rhinocerose/eurorack-jakplugg-uO_c/uO_C BOM 1.1 17 Apr 18.xlsx

Sheet: BOM
Quantity | Value | Name | RefDes | Mouser | Other | Notes
 |  |  |  | Capacitors
4 | 22p | CAP_0805 | C15, C16, C17, C18 | 77-VJ0805A220GXAPBC (https://www.mouser.com/Search/ProductDetail.aspx) |  | or 18p
4 | 560p | CAP_0805 | C22, C25, C26, C27 | 77-VJ0805A561JXAAC (http://www.mouser.com/ProductDetail/Vishay-Vitramon/VJ0805A561JXAAC/?qs=ReTA%2F0kwlVYgsqJl6lJxLg%3D%3D)
16 | 0.1u | CAP_0805 | C5, C6, C8, C9, C10, C11, C12, C13, C19, C20, C21, C30, C31, C32, C34, C35 | 80-C0805C104K5R (https://www.mouser.com/Search/ProductDetail.aspx)
3 | 0.47u | CAP_0805 | C14, C29, C33 | 581-080516C474K (https://www.mouser.com/ProductDetail/AVX/0805YC474KAT2A/)
2 | 1u | CAP_0805 | C23, C28 | 81-GCM21BR71H105KA3L (https://www.mouser.com/Search/ProductDetail.aspx)
2 | 10u | CAP_1206 | C3, C4 | 81-GRM319R61E106KA2D (https://www.mouser.com/ProductDetail/Murata-Electronics/GRM319R61E106KA12D/)
2 | 22u | CPOL-USC | C1, C2 | 667-EEE-FK1V220R (https://www.mouser.com/Search/ProductDetail.aspx) |  | 35V
2 | 10u | CPOL-USC | C7, C24 | 667-EEE-FK1E100R (https://www.mouser.com/Search/ProductDetail.aspx) |  | 25V
 |  |  |  | Resistors
1 | 4.7 | R-US_R1206 | R60 | 660-RK73B2BTTDD4R7J (http://www.mouser.com/ProductDetail/KOA-Speer/RK73B2BTTDD4R7J/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)
4 | 100 | RES_0805 | R25, R29, R33, R37 | 660-RK73H2ATTD1000F (http://www.mouser.com/ProductDetail/KOA-Speer/RK73H2ATTD1000F/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)
4 | 220 | RES_0805 | R4, R6, R10, R12 | 279-CPF0805B220RE1 (https://www.mouser.com/Search/ProductDetail.aspx) |  | 0.10% | 0.1% Not REALY needed, It will just result in less trimming adjustment
2 | 510 | RES_0805 | R40, R41 | 603-RC0805JR-07510RL (https://www.mouser.com/Search/ProductDetail.aspx)
1 | 2k | RES_0805 | R39 | 660-RK73H2ATTE2001F (https://www.mouser.com/Search/ProductDetail.aspx)
1 | 10k | RES_0805 | R42 | 660-RK73H2ATTD1002F (https://www.mouser.com/Search/ProductDetail.aspx)
4 | 24k9 | RES_0805 | R1, R2, R7, R8 | 756-PCF0805R-24K9BT1 (https://www.mouser.com/Search/ProductDetail.aspx) |  | 0.10% | 0.1% Not REALY needed, It will just result in less trimming adjustment
8 | 33k | RES_0805 | R16, R18, R20, R22, R24, R28, R32, R36 | 660-RK73H2ATTD3302F (https://www.mouser.com/Search/ProductDetail.aspx)
2 | 47k | RES_0805 | R13, R14 | 660-RK73H2ATTD4702F (https://www.mouser.com/Search/ProductDetail.aspx)
4 | 75k | RES_0805 | R26, R30, R34, R38 | 660-RK73H2ATTD7502F (https://www.mouser.com/Search/ProductDetail.aspx)
13 | 100k | RES_0805 | R3, R5, R9, R11, R15, R17, R19, R21, R23, R27, R31, R35, R53 | 279-CPF0805B100KE (https://www.mouser.com/Search/ProductDetail.aspx) |  | 0.10% | 0.1% Not REALY needed, It will just result in less trimming adjustment
 |  |  |  | Inductor
1 | 10uH |  | L1 | 963-LB3218T100K (https://www.mouser.com/Search/ProductDetail.aspx)
 |  |  |  | Semiconductors
1 |  | DAC8565 | U2 | 595-DAC8565ICPW (https://www.mouser.com/Search/ProductDetail.aspx)
1 |  | LM4040_EM3-5.0 | U6 | 926-LM4040DIM350NOPB (https://www.mouser.com/Search/ProductDetail.aspx)
1 | ADP150 3.3V | ADP150 3.3V | U7 | 584-ADP150AUJZ-3.3R7 (https://www.mouser.com/Search/ProductDetail.aspx)
1 |  | Teensy 3.2 | U1 | 485-2756 (https://www.mouser.com/Search/ProductDetail.aspx?R=2756virtualkey54950000virtualkey485-2756) |  | cheapest at osh park
1 | MB1S | MB1S | D7 | 512-MB1S (https://www.mouser.com/Search/ProductDetail.aspx?R=MB1Svirtualkey51210000virtualkey512-MB1S)
2 |  | MCP6002 | U5, U10 | 579-MCP6002T-I/SN (https://www.mouser.com/Search/ProductDetail.aspx)
2 |  | OPA2172 | U3, U4 | 595-OPA2172IDR (https://www.mouser.com/Search/ProductDetail.aspx)
1 |  | MIC803 | U12 | MIC803-26D4VM3-TR (https://www.mouser.com/ProductDetail/Microchip-Technology-Micrel/MIC803-26D4VM3-TR) |  | supervisor option
4 |  | MMBT3904 | Q1, Q2, Q3, Q4 | 512-MMBT3904 (https://www.mouser.com/Search/ProductDetail.aspx?R=MMBT3904virtualkey51210000virtualkey512-MMBT3904)
1 | LM1117-5 | REG1117T | IC6 | 511-LD1117DT50C-TR (https://www.mouser.com/Search/ProductDetail.aspx)
 |  |  |  | Controls
2 |  | PEC11 | E1, E2 | 858-EN11-HSM1BF20 (http://www.mouser.com/ProductDetail/TT-Electronics/EN11-HSM1BF20/)
2 |  | 6mm Tactile SW | U8, U9 | 612-TL1105SPF100Q (https://www.mouser.com/Search/ProductDetail.aspx)
12 |  | Thonkiconn | J1, J2, J3, J4, J5, J6, J7, J8, J9, J10, J11, J12 |  |  | Thonk/Synthcube/Erthenvar
 |  |  |  | Other Hardware
2 |  | Tact Caps |  | 612-1R-RD (https://www.mouser.com/Search/ProductDetail.aspx?R=1RREDvirtualkey61200000virtualkey612-1R-RD) |  | colors, change last letters. BLK, WHT
2 |  |  |  | 481-0007 (http://www.mouser.com/ProductDetail/Eagle-Plastic-Devices/481-0007/?qs=sGAEpiMZZMv9NFGNGF1lwip6rtQWoF3E) |  | Extra M7 Nuts for Mounting
1 | 10 pin power header | M05X2PTH | JP1 | 49-67996-410HLF (https://www.mouser.com/Search/ProductDetail.aspx)
2 |  |  |  | 761-M0505-25-N (http://www.mouser.com/ProductDetail/RAF-Electronic-Hardware/M0505-25-N/) |  | M2.5 Spacer
4 |  |  |  | 534-29301 (http://www.mouser.com/ProductDetail/Keystone-Electronics/29301/) |  | M2.5 Screws, 6mm
6 |  |  |  |  | Amazon | washer, Nylon M2.5. These need to end up to be 3mm thick so double them up, etc.
1 |  |  | RESET POGO PIN | 855-P70-2300045R (https://www.mouser.com/ProductDetail/Harwin/P70-2300045R)
1 | 7 pin 128x64 OLED |  |  | ebay, amazon, alibaba, etc.

Sheet: DISPLAY PCB
Quantity | Value | Name | RefDes | Mouser | Other | Notes
1 |  | 1306_disp_O_C | U11 |  | http://www.buydisplay.com/default/serial-spi-1-3-inch-128x64-oled-display-module-ssd1306-white-on-black
4 | 10K | RESISTOR0603MINI | R2, R4, R5, R6 |  | Resistors
1 | 390K | RESISTOR0603MINI | R3 |  | Resistors
5 | 2.2uF | CAP_CERAMIC0603MINI | C3, C4, C6, C7, C8 |  | Ceramic Capacitors
1 | 10uF | CAP_CERAMIC0603MINI | C5 |  | Ceramic Capacitors
1 |  | HEADER-1X7ROUND | JP1 |  | PIN HEADER
1 |  | DISPLAY PCB |  |  | https://oshpark.com/shared_projects/3olQy5tV
