rhinocerose/eurorack-jakplugg-uO_c/(list of files, drawings)

Other design files:
pcb-files/diptrace/uO_c1.1.dip
pcb-files/diptrace/uO_c.dch
