rhinocerose/eurorack-jakplugg-uO_c/pcb-files/eagle/uO_c.brd

## EAGLE design pcb-files/eagle/uO_c.brd (2025-08-10)

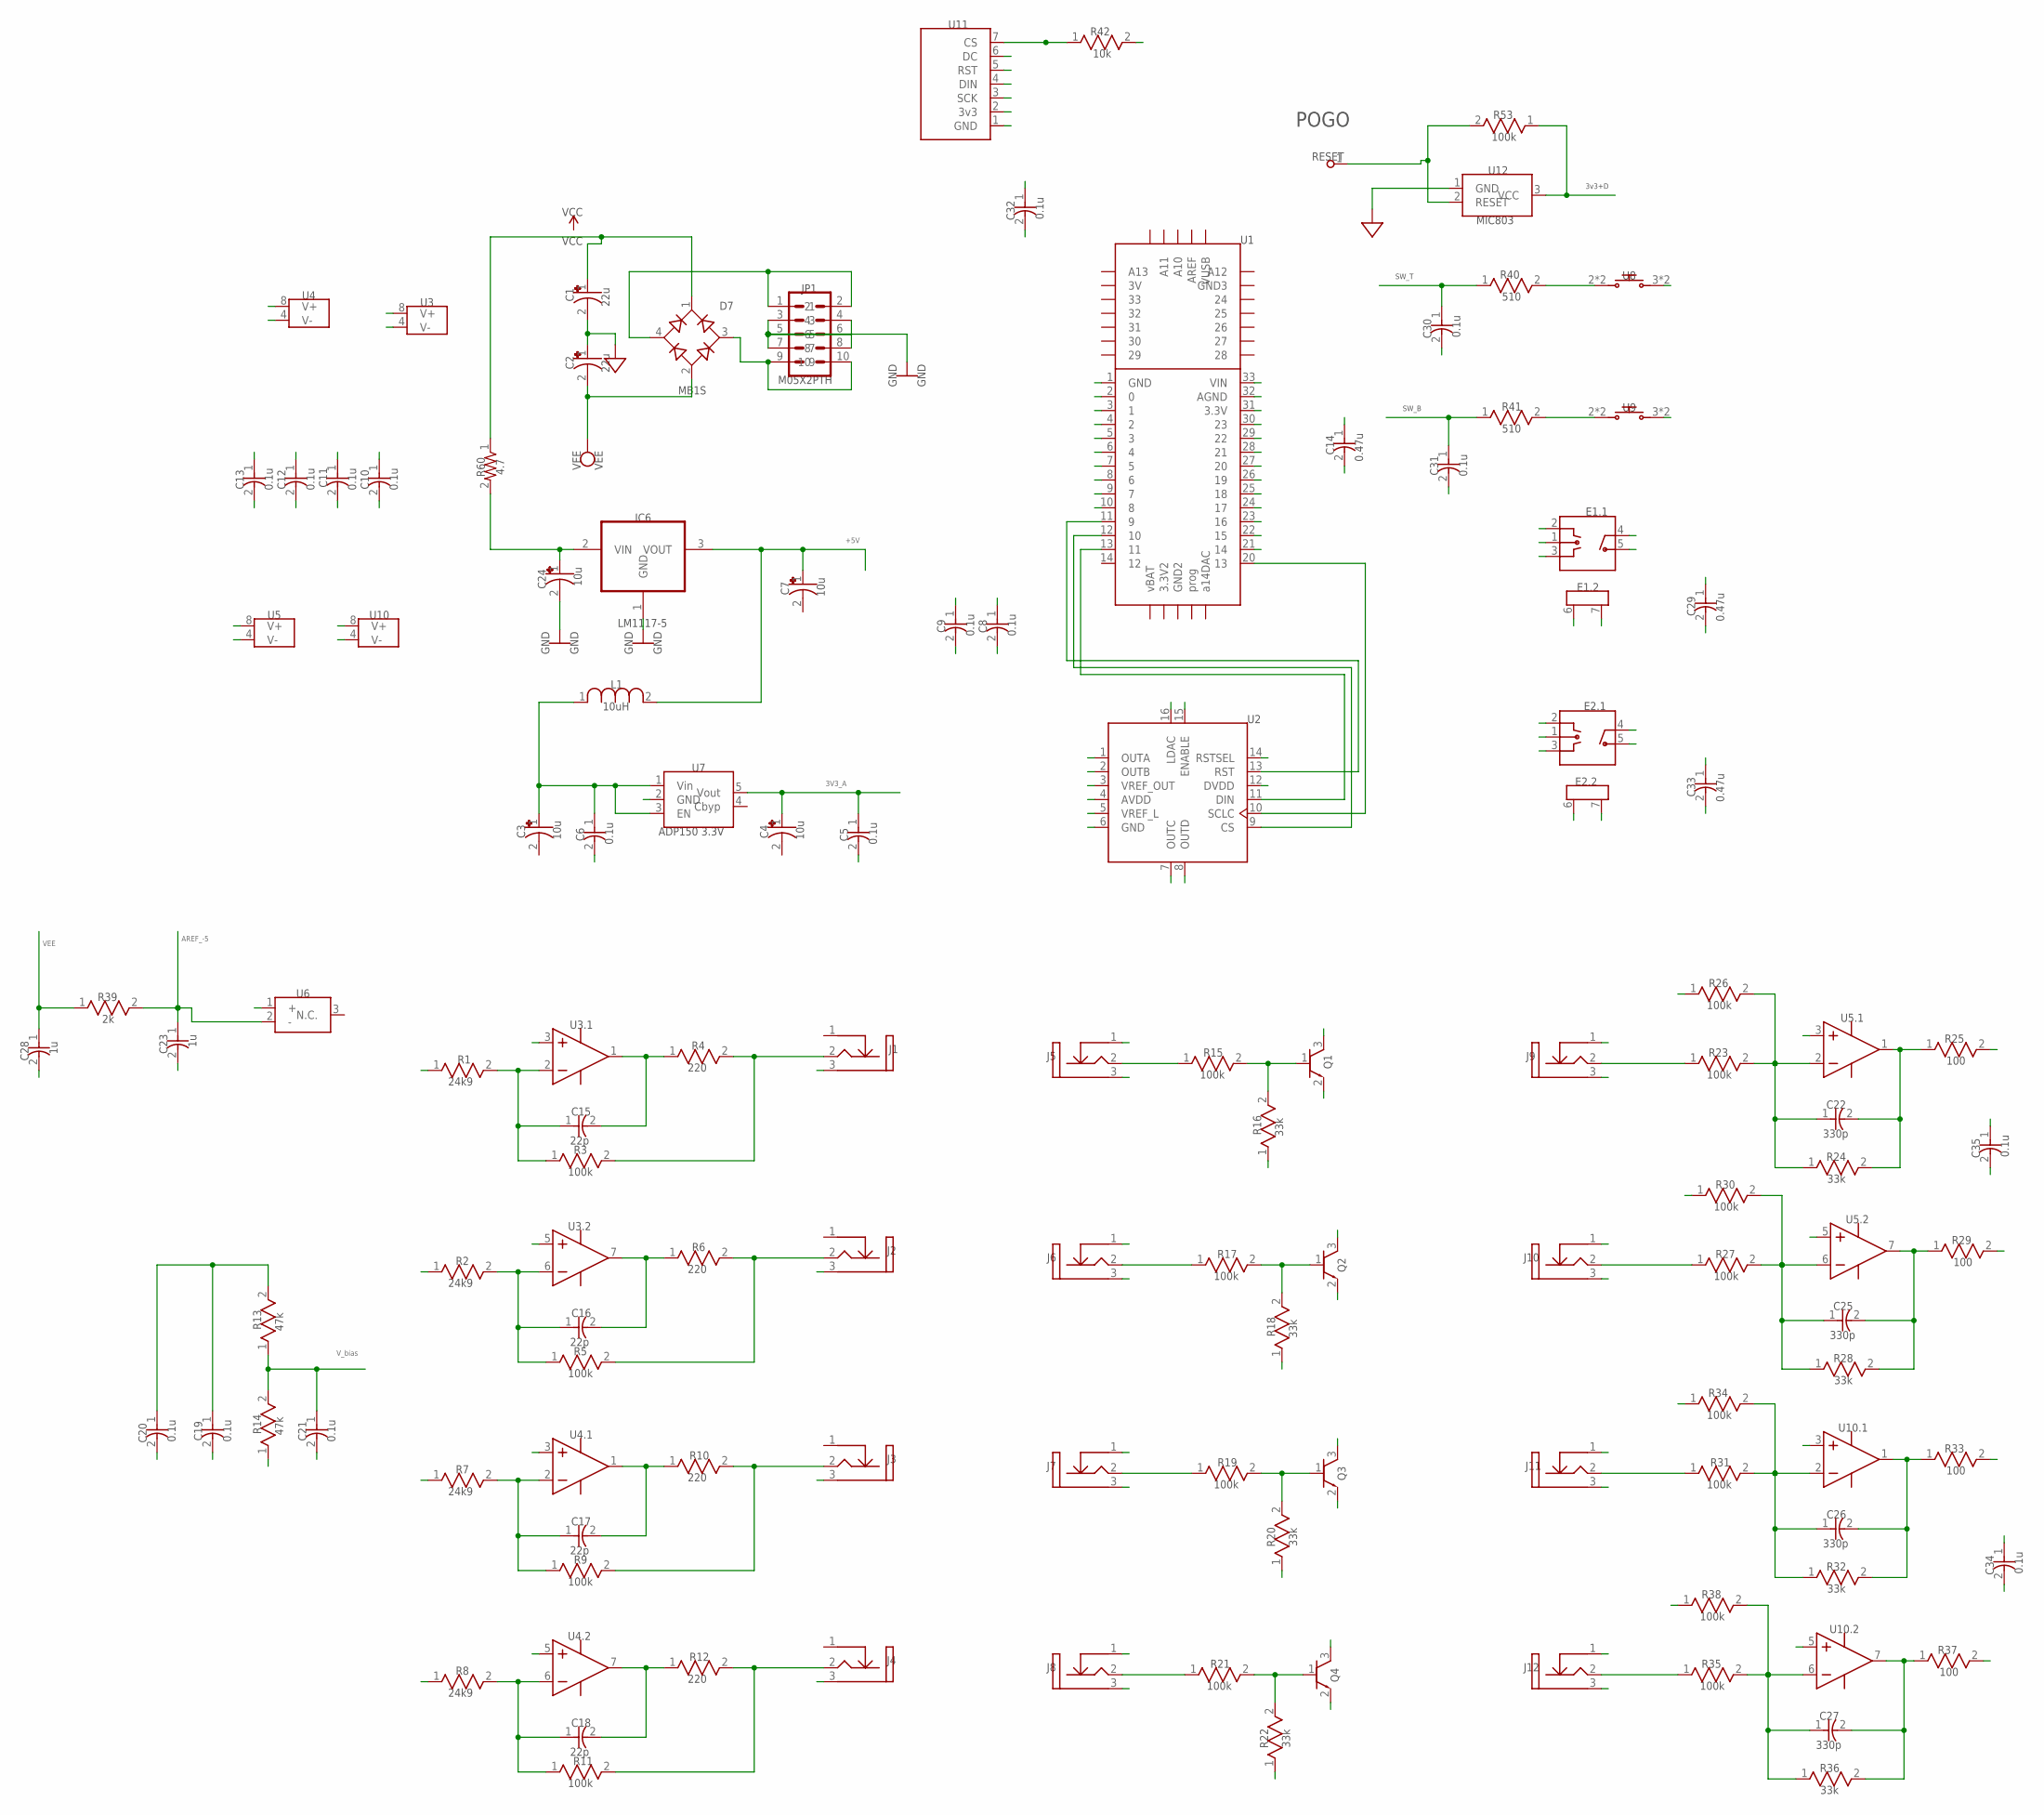
[picture p7: schematic uO_c.sch, Sheet1]

Parts:
C1, C2: 22u; CAPAE-5.3X5.3H3
C3, C4, C7, C24: 10u; CAPAE-5.3X5.3H3
C5, C6, C8, C9, C10, C11, C12, C13, C19, C20, C21, C30, C31, C32, C34, C35: 0.1u; CAP_0805
C14, C29, C33: 0.47u; CAP_0805
C15, C16, C17, C18: 22p; CAP_0805
C22, C25, C26, C27: 330p; CAP_0805
C23, C28: 1u; CAP_0805
D7: MB1S; SOP-4/6.5X2.54
E1, E2: PEC11
IC6: LM1117-5; TO252
J1, J2, J3, J4: THONKICONN; THONKICONN_JACK
J5, J6, J7, J8, J9, J10, J11, J12: THONKICONN_20; THONKICONN_JACK
JP1: M05X2PTH; AVR_ICSP
L1: 10uH; RES_1210
Q1, Q2, Q3, Q4: MMBT3904; SOT23
R1, R2, R7, R8: 24k9; RES_0805
R3, R5, R9, R11, R15, R17, R19, R21, R23, R26, R27, R30, R31, R34, R35, R38, R53: 100k; RES_0805
R4, R6, R10, R12: 220; RES_0805
R13, R14: 47k; RES_0805
R16, R18, R20, R22, R24, R28, R32, R36: 33k; RES_0805
R25, R29, R33, R37: 100; RES_0805
R39: 2k; RES_0805
R40, R41: 510; RES_0805
R42: 10k; RES_0805
R60: 4.7; R1206
RESET: RESET; ROUND-ROUND
U1: TEENSY_3.1_EDGE; TEENSY3.1_EDGE
U2: DAC8565; TSSOP-16
U3, U4: OPA2172; SOIC-8/150MIL
U5, U10: MCP6002; SOIC-8/150MIL
U6: LM4040_EM3-5.0; SOT23
U7: ADP150 3.3V; SOT23-5
U8, U9: 6MM_TACTILE_SW; TL1105SP
U11: 1306_DISP_O_C
U12: MIC803; SOT23

Connections:
3V3_A: C4.1 (+), C5.1, C9.1, C34.1, C35.1, U2.4 (AVDD), U5.8 (V+), U7.5 (Vout), U10.8 (V+)
3v3+D: C8.1, C14.1, C32.1, R42.2, R53.1, U1.31 (3.3V), U2.12 (DVDD), U11.2 (3v3), U12.3 (VCC)
+5V: C7.1 (+), IC6.3 (VOUT), L1.2, U1.33 (VIN)
AREF_-5: C23.1, R26.1, R30.1, R34.1, R38.1, R39.2, U6.2 (-)
CS_DAC: U1.12 (10), U2.9 (CS)
CS_OLED: R42.1, U1.10 (8), U11.7 (CS)
CV_1: R25.2, U1.26 (19)
CV_2: R29.2, U1.25 (18)
CV_3: R33.2, U1.27 (20)
CV_4: R37.2, U1.24 (17)
CV_A: R1.1, U2.1 (OUTA)
CV_B: R2.1, U2.2 (OUTB)
CV_C: R7.1, U2.7 (OUTC)
CV_D: R8.1, U2.8 (OUTD)
DC: U1.8 (6), U11.6 (DC)
DOUT: U1.13 (11), U2.11 (DIN), U11.4 (DIN)
ENC_L1: E1.2, U1.29 (22)
ENC_L2: E1.3, U1.28 (21)
ENC_R1: E2.2, U1.22 (15)
ENC_R2: E2.3, U1.23 (16)
GND: C1.2 (-), C2.1 (+), C3.2 (-), C4.2 (-), C5.2, C6.2, C7.2 (-), C8.2, C9.2, C10.2, C11.2, C12.1, C13.1, C14.2, C19.2, C20.2, C21.2, C23.2, C24.2 (-), C28.2, C29.2, C30.2, C31.2, C32.2, C33.2, C34.2, C35.2, E1.1, E1.5, E1.6 (gnd), E1.7 (gnd), E2.1, E2.5, E2.6 (gnd), E2.7 (gnd), IC6.1 (GND), J1.3 (GND), J2.3 (GND), J3.3 (GND), J4.3 (GND), J5.1 (TN), J5.3 (GND), J6.1 (TN), J6.3 (GND), J7.1 (TN), J7.3 (GND), J8.1 (TN), J8.3 (GND), J9.1 (TN), J9.3 (GND), J10.1 (TN), J10.3 (GND), J11.1 (TN), J11.3 (GND), J12.1 (TN), J12.3 (GND), JP1.3, JP1.4, JP1.5, JP1.6, JP1.7, JP1.8, Q1.2 ((E)), Q2.2 ((E)), Q3.2 ((E)), Q4.2 ((E)), R14.1, R16.1, R18.1, R20.1, R22.1, U1.1 (GND), U1.32 (AGND), U2.5 (VREF_L), U2.6 (GND), U2.14 (RSTSEL), U2.15 (ENABLE), U2.16 (LDAC), U5.3 (IN+), U5.4 (V-), U5.5 (IN+), U6.1 (+), U7.2 (GND), U8.3 (2), U8.4 (2), U9.3 (2), U9.4 (2), U10.3 (IN+), U10.4 (V-), U10.5 (IN+), U11.1 (GND), U12.1 (GND)
unnamed: D7.3 (AC2), JP1.9, JP1.10
Net_0: J2.2 (Tip), R5.2, R6.2
Net_1: C16.1, R2.2, R5.1, U3.6 (IN-)
Net_2: C16.2, R6.1, U3.7 (OUT)
Net_3: J3.2 (Tip), R9.2, R10.2
Net_4: C17.1, R7.2, R9.1, U4.2 (IN-)
Net_5: C17.2, R10.1, U4.1 (OUT)
Net_6: J4.2 (Tip), R11.2, R12.2
Net_7: C18.1, R8.2, R11.1, U4.6 (IN-)
Net_8: C18.2, R12.1, U4.7 (OUT)
Net_9: Q2.1 ((B)), R17.2, R18.2
Net_10: Q3.1 ((B)), R19.2, R20.2
Net_11: Q4.1 ((B)), R21.2, R22.2
Net_12: C25.1, R27.2, R28.1, R30.2, U5.6 (IN-)
Net_13: C3.1 (+), C6.1, L1.1, U7.1 (Vin), U7.3 (EN)
Net_18: C26.1, R31.2, R32.1, R34.2, U10.2 (IN-)
Net_19: J1.2 (Tip), R3.2, R4.2
Net_20: C15.1, R1.2, R3.1, U3.2 (IN-)
Net_21: C15.2, R4.1, U3.1 (OUT)
Net_22: C27.1, R35.2, R36.1, R38.2, U10.6 (IN-)
Net_35: Q1.1 ((B)), R15.2, R16.2
Net_39: J8.2 (Tip), R21.1
Net_40: J7.2 (Tip), R19.1
Net_41: J6.2 (Tip), R17.1
Net_42: J5.2 (Tip), R15.1
Net_43: C22.1, R23.2, R24.1, R26.2, U5.2 (IN-)
Net_48: C27.2, R36.2, R37.1, U10.7 (OUT)
Net_49: C26.2, R32.2, R33.1, U10.1 (OUT)
Net_50: C25.2, R28.2, R29.1, U5.7 (OUT)
Net_51: C22.2, R24.2, R25.1, U5.1 (OUT)
Net_52: J9.2 (Tip), R23.1
Net_53: J10.2 (Tip), R27.1
Net_54: J11.2 (Tip), R31.1
Net_55: J12.2 (Tip), R35.1
Net_73: C24.1 (+), IC6.2 (VIN), R60.2
Net_75: R41.2, U9.1, U9.2 (1)
Net_76: R40.2, U8.1, U8.2 (1)
Net_88: R53.2, RESET.1, U12.2 (RESET)
Net_107: D7.4 (AC1), JP1.1, JP1.2
RST: U1.9 (7), U11.5 (RST)
RST_DAC: U1.11 (9), U2.13 (RST)
SCK: U1.20 (13), U2.10 (SCLC), U11.3 (SCK)
SW_B: C31.1, R41.1, U1.6 (4)
SW_L: C29.1, E1.4, U1.30 (23)
SW_R: C33.1, E2.4, U1.21 (14)
SW_T: C30.1, R40.1, U1.7 (5)
TR1: Q1.3 ((C)), U1.2 (0)
TR2: Q2.3 ((C)), U1.3 (1)
TR3: Q3.3 ((C)), U1.4 (2)
TR4: Q4.3 ((C)), U1.5 (3)
VCC: C1.1 (+), C10.1, C11.1, D7.1 (+), R60.1, U3.8 (V+), U4.8 (V+)
VEE: C2.2 (-), C12.2, C13.2, C28.1, D7.2 (-), R39.1, U3.4 (V-), U4.4 (V-)
VREF_2v5: C19.1, C20.1, R13.2, U2.3 (VREF_OUT)
V_bias: C21.1, R13.1, R14.2, U3.3 (IN+), U3.5 (IN+), U4.3 (IN+), U4.5 (IN+)

Notes on the sheet:
SW_T
SW_B
3v3+D
POGO
22u
10u
0.1u
C10
C11
C12
C13
C14
0.47u
C15
22p
C16
C17
C18
C19
C20
C21
C22
330p
C23
C24
C25
C26
C27
C28
C29
C30
C31
C32
MB1S
E1.1
E1.2
E2.1
E2.2
GND
IC6
LM1117-5
J10
J11
J12
JP1
M05X2PTH
10uH
VCC
24k9
100k
220
R10
R11
R12
R13
47k
R14
R15
R16
33k
R17
R18
R19
R20
R21
R22
R23
R24
R25
100
R26
R27
R28
R29
R30
R31
R32
R33
R34
R35
R36
R37
R38
R39
R40
510
R41
R42
10k
VEE
U3.1
U3.2
U4.1
U4.2
U5.1
U5.2
ADP150 3.3V
U10.1
U10.2
U10
U11
C33
R60
4.7
C34
C35
R53
U12
MIC803
RESET
+5V
3V3_A
AREF_-5
V_bias

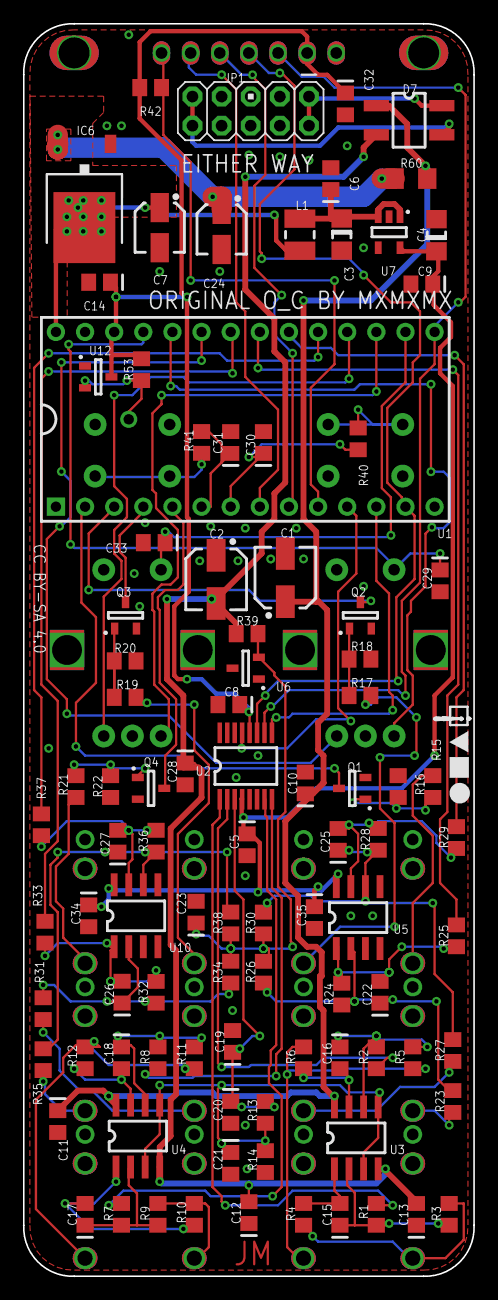
[picture p8: board uO_c.brd from above]

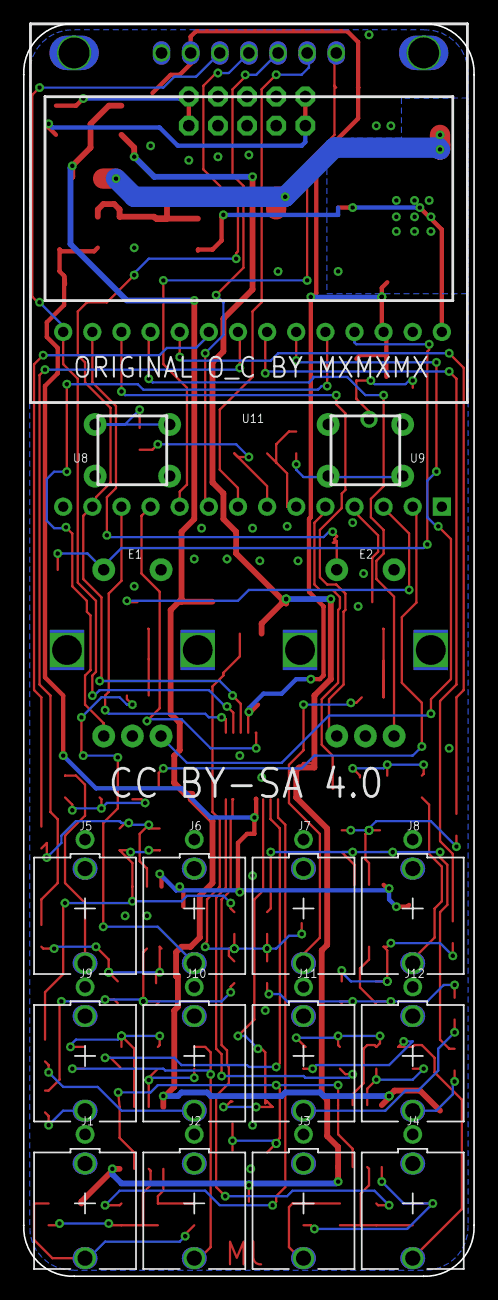
[picture p9: board uO_c.brd from below]

Board: 2 copper layers, 39.3 x 109.2 mm, 116 parts (17 on the bottom side), 75 nets.

Other parts of the board:
Pad1, Pad2: PAD; Pad
