rhinocerose/eurorack-jakplugg-uO_c/(notices)

Notices in the files:
pcb-files/eagle/uO_c.brd:
CC BY-SA 4.0
